c1scok1d/plantPulse/docs/ROADMAP.md

# PlantPulse implementation roadmap

Product-wide roadmap covering both halves: the ESP32-S3 firmware
(`github.com/c1scok1d/plantPulse`) and the Flutter app
(`github.com/c1scok1d/Plant_Pulse`). Priorities are severity/sequence-ordered,
not effort-ordered.

## Recommendations (themes)

1. ~~**Provisioning secrets travel in the clear — highest standing risk.**~~
   **✅ RESOLVED (2026-06-12).** Both cleartext-credential paths are closed:
   telemetry upload is now HTTPS (P1, commit `35cc0c3`), and BLE provisioning is
   now encrypted/bonded (`0xFEFA` is `F_WRITE_ENC`, verified on hardware — see P1).
   The WiFi password and api_token no longer travel in the clear on either path.
2. **The BLE protocol change is unverified end to end.** The app↔firmware
   alignment (service `0xFEF3`, JSON → char `0xFEFA`) analyzes clean but has only
   been verified by reading code. A real provision-to-reading round trip is the
   gate.
3. **Latent firmware fragilities.** OTA `check_update` chunked branch is buggy
   (works only because the server returns non-chunked); `current_version_number`
   is a hardcoded string compared by equality; sleep duration is selected by
   commenting code in/out; the JSON parser commits on a trailing `}`.
4. **No tests, no CI in either repo** — the BLE contract especially deserves a
   regression guard so it can't silently diverge again.

## P0 — Prove the current change works — ✅ DONE (2026-06-11)

- **End-to-end BLE verification on hardware — ✅ DONE.** Two V5 boards
  (`48CA43BBC5F4`, `48CA43BBC654`) were provisioned from the app over the new BLE
  contract (`0xFEF3` / JSON → `0xFEFA`) and readings reached the backend. The
  protocol realignment is confirmed on real hardware, not just by code review.
- **`power_source` / `charge_status` — ✅ verified end-to-end.** USB↔Battery toggle
  flips the reported value correctly (firmware GPIO13/14 → POST → backend → API).
- **Deep-sleep reboot loop — ✅ FOUND & FIXED** (commit `1ffe7da`; see P2 and
  `docs/DIAGNOSIS-2026-06-11.md`). The 8 h sleep had never actually worked on V5.
- **App provisioning confirmation (still open):** subscribe to the hostname notify
  characteristic `0xFEF9` so the user sees "provisioned ✓" instead of inferring
  success from a BLE disconnect.

## P1 — Close the credential exposure

- **Telemetry upload → HTTPS — DONE (commit `35cc0c3`).** The data POST now uses
  `https://` with `esp_crt_bundle_attach` (same root-CA path as OTA); server confirmed
  accepting it. Was plain HTTP with the api_token in the body.
- **JSON reassembly hardened — DONE (commit `35cc0c3`).** BLE config reassembly now
  commits on `cJSON_Parse` success (string-aware) instead of a trailing `}`, so a `}`
  inside a value at a chunk boundary can't trigger an early/failed parse.
- **BLE provisioning encryption — ✅ DONE & VERIFIED END-TO-END ON HARDWARE (2026-06-12).**
  `0xFEFA` (config write) is `F_WRITE_ENC` and `0xFEF9` (hostname read) is `F_READ_ENC`,
  with LE Secure Connections + bonding (`sm_sc=1`, `sm_bonding=1`,
  `sm_io_cap=NO_INPUT_OUTPUT` → Just Works). The app pairs by **reading `0xFEF9` first** —
  the encrypted read forces the link up — then writes the config over the now-encrypted
  link (firmware commits `08c225f`/`b0cb113`/`f70e254`; app `c27cdac`). Verified on a V5
  board (`48:CA:43:BB:C6:9E`) + Galaxy S23 (Android 16): encrypted read returned the
  hostname, 11 config chunks parsed (`Parsed Data: SSID=…`), creds saved to NVS, phone
  **formed a bond** (`dumpsys bluetooth_manager`, under `com.rodlandfarms.plantpulse`), and
  the device then rebooted → joined WiFi → uploaded (`POST Request Successful / HTTP 200`) →
  appeared on the dashboard → entered 8 h deep sleep. Secrets no longer travel in the clear
  over BLE. Firmware build `1781276957`.
  - The end-to-end failure seen on 2026-06-12 evening was **NOT** a BLE or deep-sleep
    regression — it was the upload NULL-client crash (see P2 "Upload crash-loop" below),
    which auto-rebooted the device right after provisioning and masqueraded as a boot loop.
    Fixed; full cycle now verified with 0 panics.
  - Residual: Just Works gives no MITM protection (encryption vs. passive eavesdropping
    only) — acceptable for an IO-less sensor; revisit if a display/keypad is ever added.

## P2 — Robustness & operability

### Confirmed firmware bugs (observed on-device 2026-06-11 — see `docs/DIAGNOSIS-2026-06-11.md`)

- **Upload crash-loop (NULL http client) — FIXED (commit `790459c`, 2026-06-12).** The POST
  handler (`rest_methods.c`) built its `esp_http_client_config_t` **without `.url`** and set
  the URL via `esp_http_client_set_url()` *after* init. But `esp_http_client_init()` requires
  a URL (or host+path) at init time — with none it logs "config should have either URL or
  host & path" and returns **NULL**; the next `esp_http_client_set_method(NULL,…)` then
  null-derefs → `StoreProhibited` panic in `uploadReadingsTask` on **every wake**. A
  freshly-provisioned device thus joined WiFi, read sensors, and crash-rebooted at the POST
  forever — looked exactly like a deep-sleep boot loop but was an upload crash (introduced by
  the `35cc0c3` POST rewrite). Fix: set `.url = server_uri` in the config + NULL-guard after
  init (skip the upload, don't crash). Verified on-device: `POST Request Successful / HTTP
  200 → Entering deep sleep 28800s`, 0 panics.
- **Deep-sleep reboot loop — FIXED (commit `1ffe7da`).** `enter_deep_sleep()` reset
  *all 48 GPIOs* (incl. USB IO19/20 and the in-package SPI-flash pins) right before
  sleeping, crashing the chip before `esp_deep_sleep_start()` → reset every ~10 s; the
  8 h sleep never actually worked on V5. Removed the loop (IDF auto-isolates GPIOs in
  sleep already); kept ext0 button-wake with an RTC pull-up + hold on IO3. Verified on
  two boards via OTA `1781229549` (they now sleep instead of looping). **Rule: never
  `gpio_reset_pin()` USB/flash/PSRAM pins.**
- **V5 pin map — FIXED (commit `1e07b93`).** Button moved GPIO6→**IO3** (`SW1`), status
  LED GPIO2→**IO34** (`LED2`), per the EasyEDA V5 source. LED blink and factory-reset
  long-press both confirmed on-device.
- **OTA TLS — FIXED (commit `c3baf43`).** Was failing with
  `ESP_ERR_MBEDTLS_SSL_SETUP_FAILED (0x8017)` against a stale pinned cert. Now uses
  `esp_crt_bundle_attach` (the ESP-IDF root-CA bundle, already in sdkconfig) — no
  pinning, trusts the new host's Let's Encrypt chain, survives LE rotation. The old
  `cert_pem*` arrays in `include/cert.h` are now unused.
- **OTA hosting — REBUILT on the new host.** `firmware.json`/`firmware.bin` were
  static files in SiteGround's docroot (not part of the Laravel app). Now served
  from `backend/ota/` bind-mounted into the container's `public/`, at
  `https://athome.rodlandfarms.com/firmware.{json,bin}`. **`version` is now a
  STRING** (firmware checks `cJSON_IsString`; the old JSON used a number, so OTA
  never fired). Current published build: **`1781229549`** (V5 deep-sleep fix). Publish
  a new one: drop a new `ota/firmware.bin` + bump the version string in
  `ota/firmware.json` — no rebuild. Versions are **unix timestamps** so a release is
  self-dating. **Current published build: `1781279162`** (upload + OTA-read fixes; replaces
  the earlier `1781229549`). Confirmed OTA works in practice: a bench V5 pulled and applied
  `1781279162` over the air on 2026-06-12 (see the OTA-read-fix bullet above).
  - **OTA "Empty firmware.json response" — FIXED (commit `338706c`, 2026-06-12).** This was
    **NOT** a server problem — the manifest was served fine (curl got the 144-byte JSON). The
    bug was in firmware `check_update()`: it called `esp_http_client_perform()` (which runs
    the whole transaction and consumes the body) and *then* `esp_http_client_read()`, which
    returned 0 → "Empty firmware.json response" → OTA never fired. Fix: `open()` +
    `fetch_headers()` + `read()` (no `perform()`). Verified OTA end-to-end on the bench V5:
    device on `1781278844` power-cycled → read manifest → saw `1781279162` newer →
    `esp_https_ota` wrote partition `0x210000` → applied → rebooted onto `1781279162` →
    settled ("No update required") → uploaded + slept. **Published build is now
    `1781279162`** (`backend/ota/firmware.json` + `firmware.bin`, bind-mounted).
    - Caveat unchanged: already-deployed devices run firmware that predates BOTH this read
      fix and the cert-bundle fix, so they can't self-OTA and still need a one-time manual
      re-flash to reach a build with working OTA. From `1781279162` onward, OTA is healthy.
- **OTA version compare — FIXED (commit `35cc0c3`).** Now monotonic: versions are unix
  timestamps and `check_update` only updates when server > current (no downgrade).
  Replaced the buggy chunked branch (read into an unallocated pointer; self-`memcpy`)
  with one small fixed-buffer read that handles both response types; uncommented
  `esp_http_client_cleanup`.
- **Undersized HTTP response buffer — FIXED (commit `35cc0c3`).** The POST handler no
  longer copies the response body into a fixed 2 KB stack buffer (no bounds check →
  overflow + ~5 s wasted wake on large error pages). The upload only needs the status
  code, so the body is ignored.
- **Provisioned-✓ notify — DONE (commit `061f3a2` fw / `d8eb599` app).** Firmware
  notifies the hostname on `0xFEF9` after saving config; the app subscribes, shows
  "provisioned ✓", and registers the device. (Internet-connectivity confirmation is a
  separate follow-up — see bottom.)

### Other P2

- ~~Fix OTA chunked branch + monotonic version compare.~~ **DONE (`35cc0c3`).**
- ~~Make sleep duration an NVS/config value.~~ **DONE (`35cc0c3`)** — `nvs_get/set_sleep_seconds`
  (default 8 h), settable via an optional `sleep_seconds` key in the provisioning JSON.
- ~~Resolve the `batteryInserted` TODO.~~ No such TODO remained in the code.
- ~~Minimal CI + BLE-contract regression test.~~ **DONE** — `firmware-build.yml`
  (ESP-IDF build) and `app-ci.yml` (`flutter analyze`/`test`); `test/ble_contract_test.dart`
  asserts the UUIDs + JSON keys match the firmware (contract extracted to
  `lib/ui/devices/ble_provisioning_contract.dart`).

## P3 — Maintainability

- **Temp/humidity/VPD sensor — BLOCKED ON HARDWARE (V6), app already ready.** Gap
  assessment (2026-06-12) found the app ships temperature/humidity/VPD charts + a disease
  catalog keyed on temp/humidity, but **V5 has no RH/T sensor** (I²C bus = MAX17048 only),
  so those fields are always null. App side is **DONE**: `IoT_monitoring_page`/`Records`
  were made null-safe (commit app `31ed455`) so the cards hide when absent and light up
  automatically when data arrives. Firmware/hardware side is a **turnkey V6 task**: add an
  SHT40 (`0x44`) on the existing I²C bus (SDA16/SCL17), probe-gate it in `monitor()` so V5
  stays unchanged, read T/RH, compute VPD, append `temp/humid/vpd` to the POST. Full plan
  (formulae, units, steps) in `hardware/README.md` → "V6 recommendation". Don't ship the
  driver until a board with the sensor exists to validate the read path.
- **Soil-probe power gating — BLOCKED ON HARDWARE (V6), firmware ready & disabled.** Battery
  analysis (2026-06-12) + the V5 EasyEDA schematic confirm `SOIL_SENSOR PWR` ties straight to
  the always-on +3V3 rail (no MOSFET/load switch on the board — census `A1 C17 D3 R14 U6 LED1
  SW1`, zero `Q`), so the probe front-end draws continuously between the 8 h reads and can't
  be gated in firmware as-is. On an 8 h duty cycle that idle drain dominates battery life —
  **measure it.** Firmware side is **DONE & inert**: `data.c` `readMoisture()` gates on read
  behind `SOIL_PWR_GPIO` (default `-1` → compiled out, V5 byte-for-byte unchanged; commit
  `9388903`). V6 hardware: add a high-side PMOS load switch on the probe rail (gate on a free
  GPIO e.g. IO21, pull-to-OFF when Hi-Z), put the SIG divider on the switched side, then set
  `SOIL_PWR_GPIO`. Full hardware+firmware plan in `hardware/README.md` → "gate the soil-probe
  power rail".
- **Solar (indoor) — V5 already has the input; harvesting is the limit, not the board.**
  V5 diode-ORs `Solar+` (Schottky) with USB into `CHRG5V` → MCP73831, so charging is
  hardware-autonomous. For the **indoor** use case a small panel is marginal (needs a
  bright window + an MPPT harvester like BQ25570); prioritize sleep-current cuts (probe gate
  above) + larger cell over indoor solar. Detail in `hardware/README.md` → "Solar charging".
- **Flutter upgrade — IN PROGRESS (now `mobile_app/plantpulse_flutter/`, Flutter 3.24.5).**
  The upgraded app exists as its own repo (`wifi_iot → wifi_scan` folded in); the old
  `Plant_Pulse` was removed. Remaining: on-device smoke-tests across screens.
- ~~Delete dead `tflite_flutter` files + stale `install.bat`; drop unused models.~~
  **DONE (app `67f8cd9`)** — removed the 4 commented `tflite_flutter` files, `install.bat`,
  and 3 unused 23 MB `.tflite` models (~67 MB). Live ML path (`model_v4_3` via ML Kit) kept.
- ~~Remove `sdkconfig.old` from the firmware repo.~~ Done.

## Follow-ups / deferred

- **Verify internet connectivity at provisioning (deferred).** Beyond "config saved",
  confirm the device actually reaches the backend and surface "online ✓" in the app.
  Options: (A) app polls `GET /user/{hostname}/latest` until the first reading [recommended,
  testable]; (B) firmware WiFi/BLE-coex HTTPS check during the BLE session notifying
  ONLINE/OFFLINE on `0xFEF9`; (C) both. Builds on the `0xFEF9` hostname notify.

## Status (2026-06-12)

P0 ✅ done · P1 ✅ **done** — encrypted BLE provisioning verified **end-to-end** on
hardware (2026-06-12): provision → bond → WiFi → `POST 200` → dashboard → 8 h deep
sleep, 0 panics. The "still failing" state from the night before turned out to be the
**upload NULL-client crash** (P2, fixed `790459c`), not BLE/sleep. · P2 ✅ done · P3: app
cleanup ✅, **Flutter upgrade in progress** — the
upgraded app now lives in a new repo `mobile_app/plantpulse_flutter/`
(`github.com/c1scok1d/plantpulse_flutter`, Flutter 3.24.5 / Dart 3.5.4, `wifi_scan`
swap folded in); installs and runs on the S23. A startup crash from the
`firebase_messaging` upgrade (inline `onBackgroundMessage` closure → null callback
handle) was fixed with a top-level `@pragma('vm:entry-point')` handler.

**Backend note:** `athome.rodlandfarms.com` was 500-ing on 2026-06-11 (PHP 8.2 +
old `nesbot/carbon`; see `docs/DIAGNOSIS-2026-06-11.md`). It has since been
**migrated off SiteGround onto the local Docker fleet** (`~/Desktop/plantPulse/backend/`,
app on `127.0.0.1:8003`, DNS cut over to this box) and is **up and serving clean JSON
as of 2026-06-12** — the shared-host PHP-auto-upgrade risk is now gone. Full record in
`docs/BACKEND-MIGRATION.md`. Remaining edge: a device provisioned while the API was down
may hold a stale `api_token`; re-login + re-provision to refresh it.

**Open items:** (1) **One-time manual re-flash of already-deployed devices** — they run
firmware predating the OTA-read + cert-bundle fixes, so they can't self-OTA; once re-flashed
to ≥`1781279162`, OTA is healthy going forward. (2) Flutter upgrade smoke-tests on remaining
screens. The bench V5 is fully healthy: provisioning, upload, dashboard, OTA, and 8 h sleep
all verified end-to-end on 2026-06-12.
