c1scok1d/plantPulse/(list of files, drawings)

Other design files:
hardware/EasyEDA_Pro/ESP32 Soil.epro
