c1scok1d/plantPulse/include/data.h

#ifndef _DATA_H_
#define _DATA_H_
#include <stdbool.h>  // Add this to use 'bool' in C


//void getBattery();
//void readMoisture();  // Updated declaration with parameter
//void battery_monitor();

// Define a typedef for BatteryStatus
typedef struct {
    float soc;
    bool status;
    float crate;
} BatteryStatus;

BatteryStatus getBattery();  // Declaration of getBattery function
int readMoisture();  // Declaration of readMoisture function
void check_update();
void take_reading();  // Declaration of take_reading function
void monitor();  // Declaration of battery_monitor function
void monitor_task(void *pvParameters);  // runs monitor() in a task with a TLS-safe stack

#endif
