c1scok1d/plantPulse/(commit log)

2024-12-19 added ble_advert function; ble advertises when wifi fails to connect;
    [main.c, main.h]
2024-12-19 added logging and fixed BLE advertisements
    [main.c]
2024-12-20 changed ble device name advertisement
2024-12-23 added api token; fixed uuid advertisement
    [main.c]
2024-12-23 factory default on button push
2024-12-23 added long button press for nvs erase
2024-12-23 added uuid to ble advertisement; added long button press for factory reset; added enter_deep_sleep from data.c
    [data.c, main.c, main.h]
2024-12-27 added SERVICE_CHR_UUID; added API_TOKEN_UUID; began work on blinking led when ble is advertising; added logging tags
2025-01-02 updated voltage calculations and output values
2025-01-13 adjusted voltage and moisture calculations
2025-02-03 changed battery voltage monitor
2025-02-06 battery returns soc and batteryInserted; need to fix batteryInserted
    [data.c, data.h]
2025-02-09 added battery stuff
2025-02-09 fixed cert stuff, working on ota
    [cert.h, main.c]
2025-02-12 added battery saving features
2026-06-10 docs: track CLAUDE.md (firmware architecture + BLE contract)
    Add the previously-untracked CLAUDE.md documenting the boot/sleep
    cycle, pin map, OTA flow, and the BLE provisioning GATT contract
    (service 0xFEF3, config char 0xFEFA, JSON keys) shared with the
    companion mobile app.
2026-06-11 docs: on-device diagnosis, firmware bugs, backend migration plan
    DIAGNOSIS-2026-06-11.md: full serial-console verification of a real V5
    board. Device/WiFi/sensors/upload all work; root cause of "no reading in
    app" is the backend 500-ing on a PHP 8.2 / nesbot/carbon incompatibility.
    ROADMAP.md (P2): log the two confirmed firmware bugs — broken OTA
    check_update (JSON parse + TLS setup failure) and the undersized HTTP
    response buffer that spams overflow warnings and wastes battery.
    BACKEND-MIGRATION.md: phased plan + open questions for moving
    RodlandFarmsAPI off cPanel shared hosting onto the local Docker fleet.
2026-06-11 OTA: trust ESP-IDF cert bundle instead of pinning a cert
    Switch both OTA HTTPS configs (check_update + perform_ota_update) from
    `.cert_pem = cert_pem2` to `.crt_bundle_attach = esp_crt_bundle_attach` — the
    full root-CA bundle already compiled into the firmware
    (CONFIG_MBEDTLS_CERTIFICATE_BUNDLE=y). It trusts the public root store that the
    new host's Let's Encrypt chain anchors to (leaf <- YE1 <- Root YE <- ISRG Root
    X2 <- ISRG Root X1), fixing the OTA TLS setup failure and surviving all future
    LE intermediate/root rotation with zero cert maintenance.
    Also fix check_update's URL, which was http:// with OVER_SSL transport
    (contradictory) -> the HTTPS JSON_URL. The pinned certs in cert.h are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
    [main.c]
2026-06-11 Bump OTA version to 1781210071 for the cert-bundle release
    This is the firmware now published as athome.rodlandfarms.com/firmware.bin
    (served from backend/ota/, version string matched in firmware.json). Devices
    running older firmware with working OTA will pull this build; devices already
    on it see version == current and don't re-update. Pairs with the cert-bundle
    OTA change (c3baf43) so the HTTPS fetch verifies the new host's LE chain.
2026-06-11 docs(roadmap): record OTA TLS fix, OTA hosting setup, version-compare risk
    OTA TLS is fixed (cert bundle, c3baf43); firmware.json/bin now served from
    backend/ota/ via bind-mount with a STRING version. Flag the remaining
    strcmp!=0 downgrade risk and the still-buggy chunked check_update branch.
2026-06-11 Fix OTA crash: run monitor() in a 16KB-stack task
    check_update() does a cert-bundle mbedTLS HTTPS handshake but ran in the WiFi
    event-handler task (CONFIG_ESP_SYSTEM_EVENT_TASK_STACK_SIZE=2304B). The handshake
    overflowed that stack and instant-reset the device the moment OTA ran (the old
    pinned-cert build failed at TLS setup, before the deep handshake, so it never
    overflowed). Run monitor() — the OTA check + sensor read + upload — in its own
    16KB-stack task instead.
    Verified on-device: OTA_CHECK now returns HTTP 200 over the Let's Encrypt cert
    bundle, the version compare is correct (1781210071 == current, no spurious
    update), and the cycle completes to an 8h deep sleep.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
    [data.c, data.h]
2026-06-11 docs: add cross-layer enhancement roadmap (ENHANCEMENTS.md)
    Grounds the hardware/firmware/backend/frontend gaps in the code: temp/humidity/
    vpd columns are intentional forward-provisioning for future sensors, while the
    real near-term wins are current-hardware — activate the dead command channel
    (runtime cadence/restart/diagnostics), per-plant thresholds (connect the app's
    Farm + IoT halves), and fleet health/OTA management. Also flags a real bug:
    data ingest is coupled to FCM (400s and drops the reading if no fcm_token).
2026-06-11 Send charge_status; fix unsigned MAX17048 charge-rate read
    Add charge_status (charging/discharging/idle) to the data POST, derived from the
    MAX17048 charge rate — the backend column already exists. Also fix getBattery():
    CRATE is a signed two's-complement register (LSB 0.208 %/hr); it was read unsigned
    and /256, so discharge logged garbage (e.g. "13620 %/hr"). Now signed + correctly
    scaled, which is what charge_status keys off.
    [data.c]
2026-06-11 Add power_source from USB_DETECT/STAT (GPIO13/14)
    Read USB_DETECT (GPIO13 = USB present) and the MCP73831 STAT line (GPIO14,
    open-drain, active-low = charging) per the V5 board (hardware/Schematic.png),
    and derive power_source (USB / Solar / Battery — solar inferred, since the board
    diode-ORs USB+solar with no dedicated solar-sense line). charge_status now keys
    off STAT (charge rate is just the discharge/idle tiebreaker). Both fields added
    to the data POST; the backend columns already exist.
    On-device verification pending (flash + plug/unplug USB -> GPIO13 should toggle).
2026-06-11 Fix static-creds hatch: #ifdef guard + set SSID
    The compile-time WiFi escape hatch was doubly broken: `#if STATIC_PASSWORD`
    evaluates a string literal (preprocessor error / never the intended path),
    and the branch only copied the password, never the SSID — so even when
    enabled it could never connect. Switch to `#ifdef STATIC_PASSWORD` and copy
    STATIC_SSID into wifi_config. Macros stay commented out (no creds in source);
    this just makes the hatch usable for bench bring-up.
2026-06-12 Fix V5 button + LED pins (IO3 / IO34)
    The board in hand is V5, confirmed against the EasyEDA source: SW1 (button) is
    on IO3 and the status LED (LED2) is on IO34. The firmware still used the older
    GPIO6 (button) and GPIO2 (LED), so the factory-reset long-press and the
    provisioning blink LED were both wired to the wrong pins on V5.
    - BUTTON_GPIO 6 -> 3 (IO3 is RTC-capable, so ext0 deep-sleep wake still works)
    - LED_GPIO 2 -> 34
    [main.c]
2026-06-12 Fix deep-sleep crash loop: drop fatal all-GPIO reset
    The real cause of the ~10s reboot loop (not ext0, not brownout): enter_deep_sleep()
    ran a loop that gpio_reset_pin()'d all 48 GPIOs to "reduce leakage" right before
    sleeping. That reset the USB pins (IO19/20) and, fatally, the in-package SPI-flash
    pins — crashing the chip before esp_deep_sleep_start() ever ran, so it reset and
    repeated forever instead of sleeping. Confirmed on-device: with the loop removed the
    device holds a steady 60s test cadence (was ~10s); restored to 8h for production.
    - Remove the all-GPIO reset loop. ESP-IDF already isolates GPIOs in deep sleep
    (sdkconfig "isolate all GPIO pins in sleep state"), so it was redun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
    [main.c]
2026-06-12 docs: record deep-sleep crash-loop fix + V5 verification
    Update DIAGNOSIS-2026-06-11 with the reboot-loop root cause (all-GPIO reset in
    enter_deep_sleep crashing on USB/flash pins), the ruled-out theories (ext0,
    brownout, timer), the fix, and on-device verification. Update ROADMAP: mark P0
    (BLE end-to-end, power_source, reboot loop) done, log the deep-sleep + V5 pin
    fixes under P2, and refresh the published OTA build to 1781229549.
2026-06-12 Firmware robustness batch: HTTPS upload, OTA monotonic, NVS sleep, robust JSON
    - Telemetry POST now uses HTTPS with the root-CA bundle (same path OTA uses);
    was plain HTTP with the api_token in the body. Server confirmed accepting it.
    - POST response handler no longer copies the body into a fixed 2KB stack buffer
    with no bounds check (overflowed + wasted ~5s of wake time on large error
    pages). The upload only needs the status code.
    - OTA version compare is now monotonic: versions are unix timestamps, update only
    when server > current (no accidental downgrade). Replaced the buggy chunked
    branch (read into an unallocated pointer; self memcpy) with one small fixed-buf
    read that work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
    [data.c, main.c, main.h, rest_methods.c]
2026-06-12 Confirm provisioning to app: notify hostname on 0xFEF9 after config save
    After parse_json() saves the WiFi/sensor config to NVS, notify the hostname on the
    0xFEF9 characteristic. By then the app has connected and subscribed, so (unlike the
    connect-time notify, which fires before the app's CCCD write) this one is reliably
    delivered. The app uses it as an explicit "provisioned ✓" signal — and as the
    device hostname needed to register the device with the backend — instead of merely
    inferring success from the BLE disconnect.
2026-06-12 CI: compile-check firmware on push/PR
    Add GitHub Actions (.github/workflows/firmware-build.yml) running an ESP-IDF v5.3.2
    idf.py build for esp32s3 so a build break can't land on main.
2026-06-12 docs(roadmap): mark P0-P2 + app cleanup done; flag BLE-encryption + Flutter-upgrade as device-needed
2026-06-12 Encrypt BLE provisioning: require encrypted link to write config (0xFEFA)
    The config characteristic (0xFEFA) now requires an encrypted link
    (BLE_GATT_CHR_F_WRITE_ENC), so the WiFi password and api_token are no longer written
    over the air in the clear. The sensor has no display/keyboard, so pairing is LE Secure
    Connections "just works" (sm_io_cap = NO_INPUT_OUTPUT) with bonding; ble_store_config_init()
    provides key storage. BLE_GAP_EVENT_REPEAT_PAIRING deletes a stale bond and retries so
    re-provisioning a rebooted device always works; ENC_CHANGE is logged.
    NOT yet OTA-deployed — to be bench-verified (phone↔board pairing + a full provision)
    before publishing, since a pairing mismatch woul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
    [main.c]
2026-06-12 BLE provisioning robustness for encryption: don't reboot until provisioned
    With the config char now requiring encryption, the OS pairing handshake can drop the
    BLE link before the config is written. The old handler rebooted on EVERY disconnect,
    wiping provisioning progress (NVS stayed empty, LED kept flashing). Now reboot only
    when main_struct.isProvisioned is set (config saved in device_write); otherwise
    re-advertise so the app can reconnect and finish. Pairs with the app-side write retry.
    [main.c]
2026-06-12 BLE provisioning: pair via encrypted read first (no write retry)
    Gate the hostname char (0xFEF9) READ behind encryption and drop the connect-time
    notify. The app now READs 0xFEF9 on connect, which triggers OS pairing and only
    returns once the link is encrypted; it then writes config once (no retry). This also
    removes the connect-time notify that immediately preceded the nimble_host watchdog
    hang in the previous attempt. Confirmation notify still sent from device_write.
2026-06-12 docs(roadmap): BLE-encryption handshake verified on HW; full provisioning still failing
    Encrypted BLE provisioning handshake confirmed on a V5 board + Galaxy S23:
    encrypted read of 0xFEF9, accepted encrypted write to 0xFEFA, and a real BLE
    bond formed (dumpsys, under com.rodlandfarms.plantpulse). Secrets no longer
    travel in the clear over BLE (recommendation #1 path closed).
    But the end-to-end provision-to-reading cycle is NOT yet working: after the
    config write the device doesn't complete provisioning and a deep-sleep boot
    loop may have regressed (cf. 1ffe7da; possibly from the b0cb113 reboot change).
    Item left OPEN with a next-session action: serial-monitor the bench device
    during a provi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
2026-06-12 docs(roadmap): correct backend note — already migrated to local fleet, not a shared-host fix
2026-06-12 fix(upload): set .url at http client init — was NULL-deref crash-looping the device
    esp_http_client_init() requires a URL (or host+path) in the config at init time.
    The POST handler left .url unset and called esp_http_client_set_url() afterward,
    so init returned NULL ("config should have either URL or host & path") and the
    following esp_http_client_set_method(NULL,...) dereferenced it -> StoreProhibited
    panic in the upload task every wake. Net effect: a freshly-provisioned device
    joined WiFi, read sensors, then crash-rebooted at POST forever (looked like a
    deep-sleep boot loop; it was an upload crash).
    Fix: set .url = server_uri in the config initializer and add a NULL guard after
    init so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
    [main.c, rest_methods.c]
2026-06-12 fix(ota): read firmware.json via open/fetch_headers/read — perform() ate the body
    check_update() called esp_http_client_perform() (which runs the whole transaction
    and consumes the response body internally) and THEN esp_http_client_read(), which
    returned 0 — so every check logged "Empty firmware.json response" and OTA never
    fired, even though the server served a valid 144-byte manifest. Same root family
    as the upload-crash: a misuse of the esp_http_client API from the 35cc0c3 rewrite.
    Fix: use the low-level esp_http_client_open() + fetch_headers() + read() + close()
    sequence (no perform()), which leaves the body for us to read. Gate on
    status==200 && bytes>0 and log status/len on failur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
    [main.c]
2026-06-12 docs(roadmap): C1 temp/humidity gap — app made ready, V6 sensor is turnkey
    Gap assessment found the app ships temp/humidity/VPD UI but V5 has no RH/T
    sensor (I2C = MAX17048 only). App side done (null-safe, app 31ed455); firmware
    side is a turnkey V6 task (SHT40 on existing I2C, probe-gated) documented in
    hardware/README.md. Also reflects Flutter upgrade now in plantpulse_flutter.
    EOF
2026-06-12 fix(wifi): run ble_advert() in its own task, not the 2304 B event task
    On WiFi failure the handler fell back to BLE re-provisioning by calling
    ble_advert() — which inits the whole NimBLE host stack — directly inside the
    system-event task (CONFIG_ESP_SYSTEM_EVENT_TASK_STACK_SIZE=2304). That overflows
    the stack and resets the chip in a loop, so a device whose provisioned network
    disappears (router change, moved location) crash-loops instead of falling back to
    BLE provisioning. Same class of bug already fixed for monitor() by giving it a
    16 KB task. Now both ble_advert() call sites in wifi_drv.c spawn an 8 KB
    ble_advert_task. Bumped version to 1781292685.
    (Found while diagnosing a bench re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
    [main.c]
2026-06-13 feat(power): add disabled-by-default soil-probe power gating
    V5 wires SOIL_SENSOR PWR straight to the always-on +3V3 rail — there is no
    MOSFET or load switch anywhere on the board (confirmed against the V5 EasyEDA
    schematic: census A1 C17 D3 R14 U6 LED1 SW1, zero Q). So the capacitive probe
    front-end draws continuously between the 8-hourly reads, and firmware alone
    cannot gate what the hardware doesn't switch.
    Add a parameterized gate-on-read in readMoisture() (power up -> settle ->
    sample -> power down), guarded by SOIL_PWR_GPIO. Default -1 compiles the gating
    out, so V5 stays byte-for-byte identical (safe over OTA). A board that adds a
    high-side load switch on the probe rail (V6, or a V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
    [data.c]
2026-06-13 docs(roadmap): record soil-probe power-gating + indoor-solar findings (V6)
2026-06-13 feat(power): default soil-probe gating to V6 PMOS topology (GPIO21, active-low)
    Flip SOIL_PWR_ACTIVE_LEVEL default to 0 (active-low) to match the recommended
    V6 high-side PMOS load switch on the sensor rail, and document the topology +
    the TLC555 24/7-drain finding in the comment. SOIL_PWR_GPIO stays -1 so the V5
    fleet (no load switch) remains byte-for-byte identical over OTA; a V6 build just
    sets it to GPIO_NUM_21. Full sub-circuit + BOM in hardware/README.
    [data.c]
2026-06-13 hardware: bring the EasyEDA project + docs into the firmware repo
    The PlantPulse hardware design (EasyEDA Pro project for the ESP32-S3 soil
    sensor, all revisions incl. V5, plus the hardware/README reference and the
    legacy C3-mini production files) previously lived beside the firmware repo and
    was untracked. Move it under firmware/hardware/ so it is version-controlled
    alongside the firmware it pairs with, and so the firmware's hardware/README
    references resolve repo-relative.
    [BOM.csv, ESP32 Soil.epro, PickAndPlace.csv]
2026-06-13 docs(hardware): add V6 SHT40 sub-circuit (always-on rail + layout)
    Concrete SHT40-AD1B addition on the existing I2C bus (0x44, reuse MAX17048 bus
    pull-ups, 100nF decoupling). Specify VDD on the always-on +3V3 rail, NOT the
    switched SENSOR_3V3: the SHT40 idles sub-uA so gating saves nothing, and a
    powered-down sensor on the always-on-pulled I2C bus would back-feed through its
    ESD diodes (~0.5mA), wasting more than it saves. Add thermal-placement note
    (away from LDO/charger/MCU self-heating). Corrected the load-switch section and
    add/enhance/remove summary that had wrongly placed the SHT40 on the switched rail.
2026-06-13 docs(hardware): draft optional V6 SOLAR_SENSE divider + MAX17048 ALRT wake
    SOLAR_SENSE: 1M/820k divider from the panel node (Schottky panel side) to
    IO4/ADC1_CH3 + 100nF, so solar is measured (panel producing vs dark/dead)
    rather than inferred from USB_DETECT/STAT. ADC1 to avoid the WiFi/ADC2 clash.
    ALRT: 100k pull-up on the MAX17048 open-drain ALRT to IO18 (RTC-capable) for
    deep-sleep low-battery wake; move button+ALRT to ext1 ANY_LOW since ext0 is
    single-pin. Both guarded behind defines so the V5 fleet is unaffected. Added a
    V6 new-pin summary (IO21/IO4/IO18 + SHT40 on I2C).
2026-06-13 hardware(v6): add JLCPCB fabrication-support package
    firmware/hardware/v6/: new-parts BOM (LCSC #s), exact net-by-net additions for
    EasyEDA, a CPL template, and the EasyEDA->JLCPCB workflow. Gerbers themselves
    must be exported from EasyEDA after laying out the new parts (no V6 layout
    exists yet); these files make that export + the JLC order turnkey.
    [BOM_v6_additions.csv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]
2026-06-13 fix(upload): synchronous + retried upload so readings aren't silently lost
    Devices used to fire a detached upload task and then deep-sleep after a fixed 3 s
    delay — shorter than the 8 s HTTP timeout — so a slow TLS upload on weak WiFi was
    cut off mid-flight and the 8-hourly reading was lost (reads as 'device offline').
    Single-shot POST also meant any transient failure dropped the reading.
    Make uploadReadings() synchronous with a 3-attempt linear backoff (1.5s, 3s); it
    runs in monitor_task (large stack) and monitor() deep-sleeps only after it returns.
    Removes the detached task + malloc and the racing 3 s delay. Returns success/fail
    (logged). Builds clean on ESP-IDF v5.3.2.
    NOTE: current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
    [data.c]
2026-06-13 ota: bump current_version_number to 1781375990 (publish synchronous-upload fix)
    Bench-validated on a reflashed V5 (48CA43BBC5F4): provisioned -> WiFi -> the new
    synchronous+retried upload -> fresh backend reading -> clean deep sleep. Published
    to the fleet OTA (athome.rodlandfarms.com/firmware.{json,bin}); served bin md5
    matches this build. Pairs with the upload fix 0e26e1c.
    [main.c]
